VadSiniak/SDS_EV_Charger/README.md

# SDS_EV_Charger
Project helps to make your own low cost EV Charger 

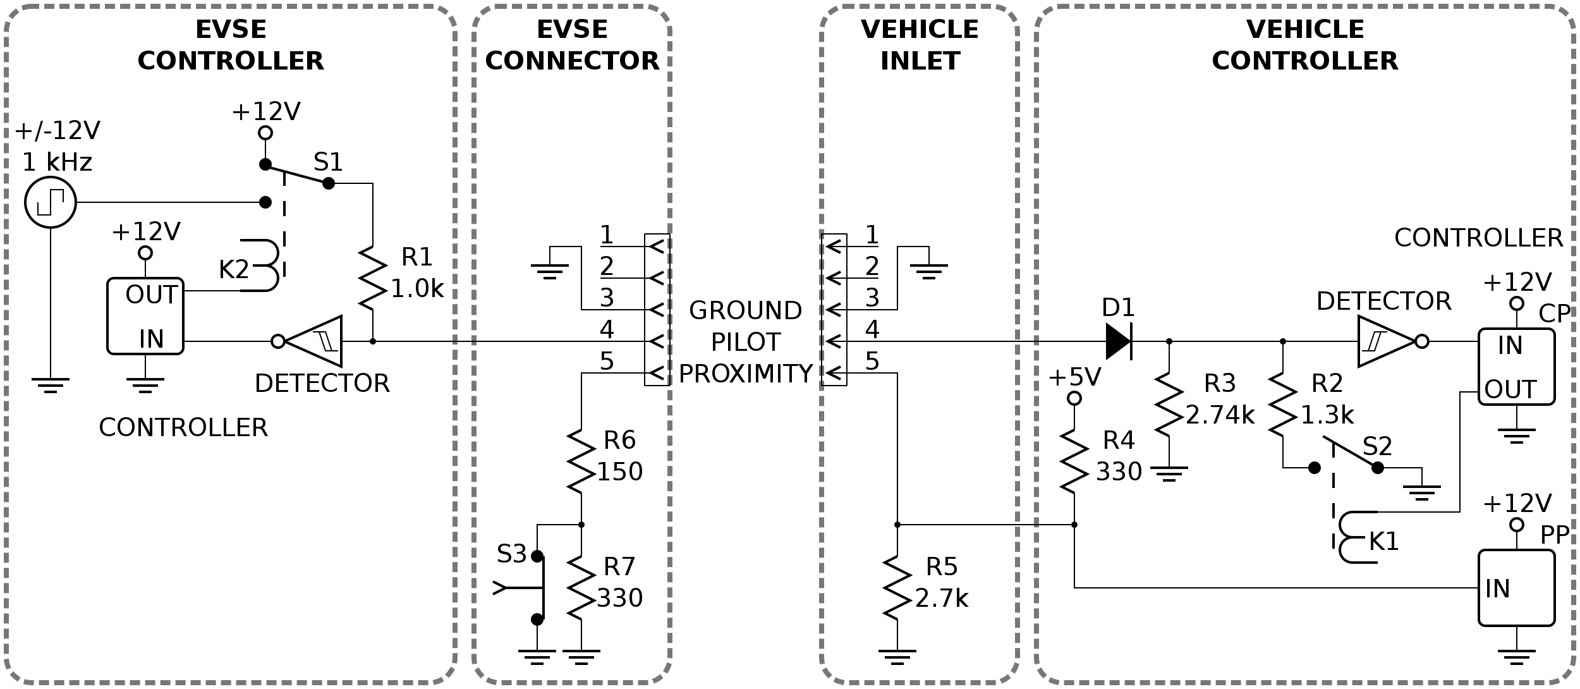
[picture p1: IMG/J1772_signaling_circuit.svg.png]
Schema: EV charger <-> EV


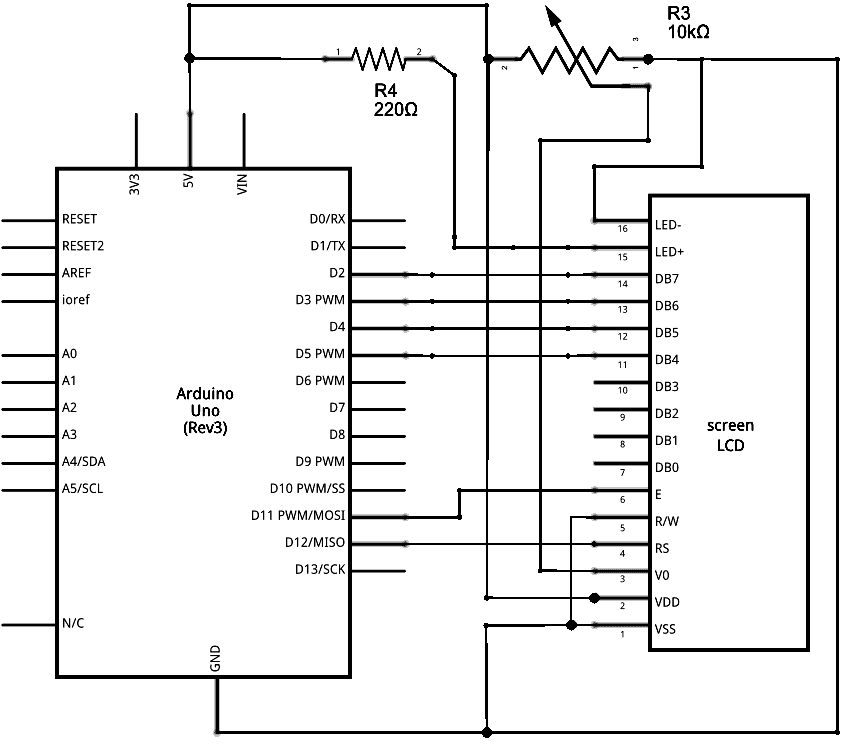
[picture p2: IMG/LCD_Base_bb_Schem.png]
LCD schema
