VadSiniak/SDS_EV_Charger/EV_Charger_home_v1.3/KiCad_proj/EV_Charge.kicad_pcb

## KiCad design EV_Charger_home_v1.3/KiCad_proj/EV_Charge.kicad_pcb (2025-04-10)

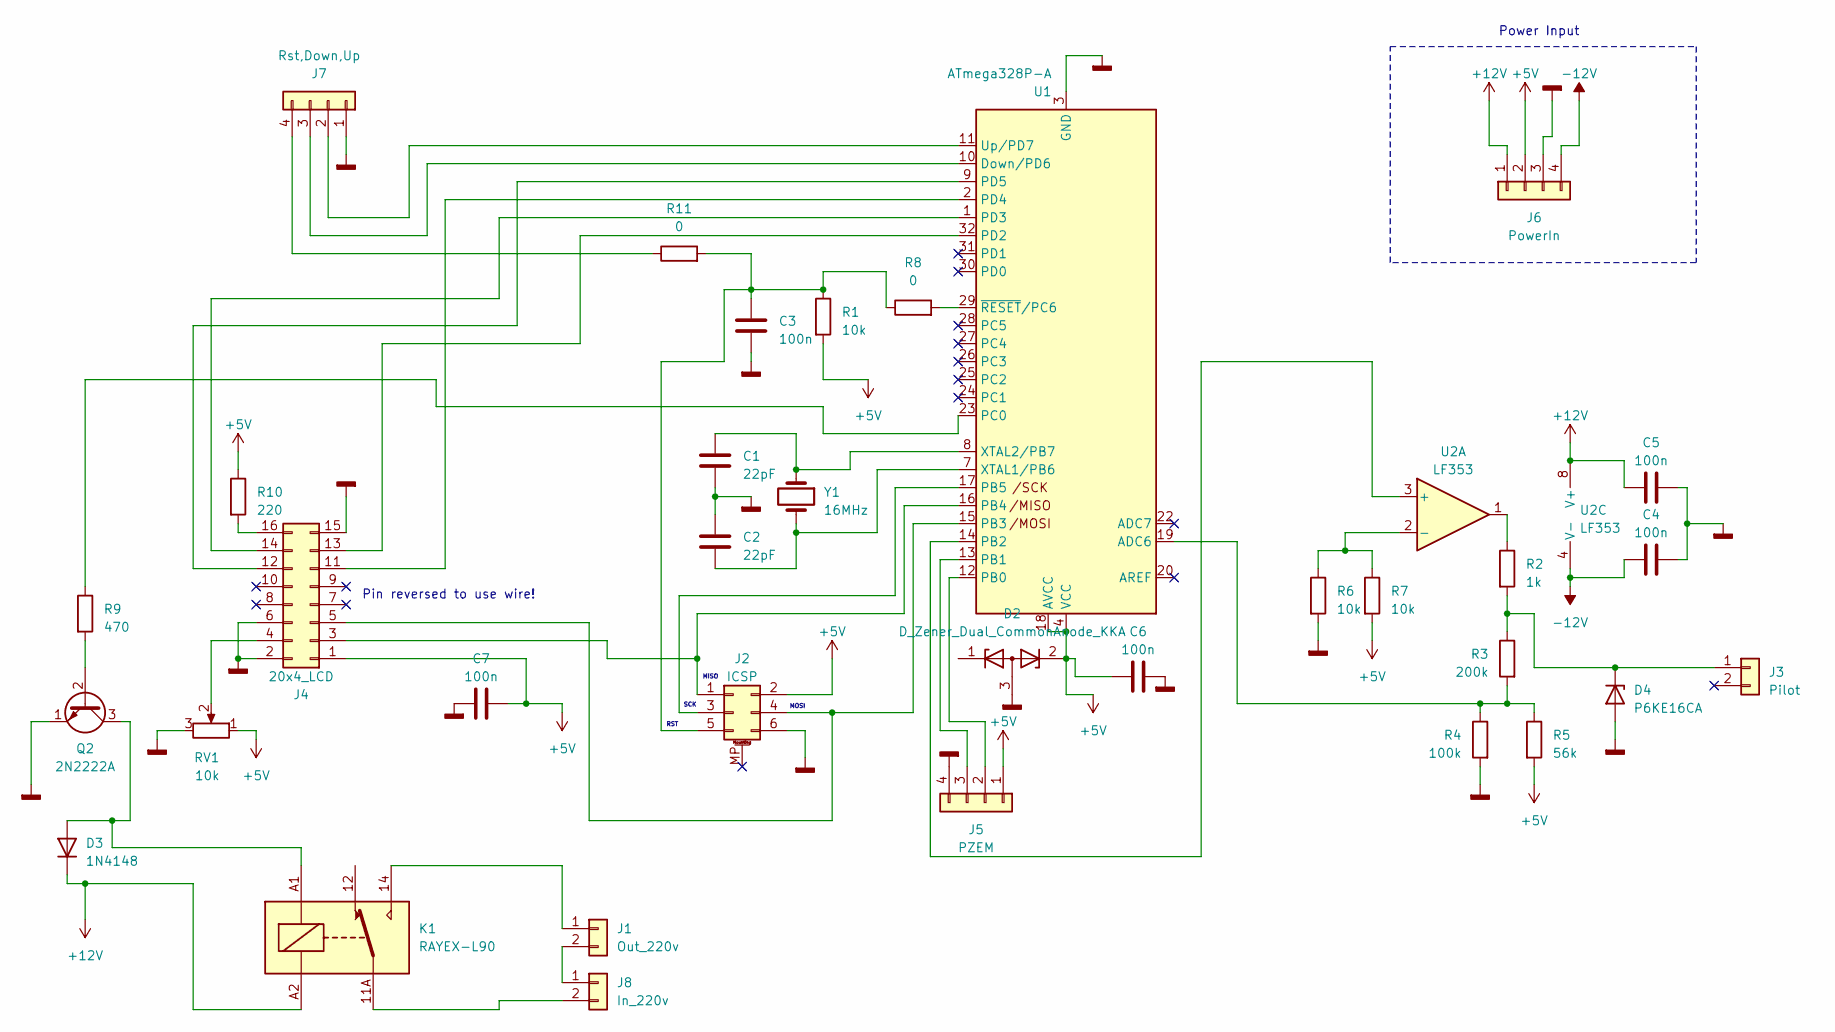
[picture p3: schematic EV_Charge.kicad_sch, J1772 Type1 - Electric Vehicle Charger]

Parts:
C1, C2: 22pF; C_1206_3216Metric_Pad1.33x1.80mm_HandSolder
C3, C4, C5, C6, C7: 100n; C_1206_3216Metric_Pad1.33x1.80mm_HandSolder
D2: D_Zener_Dual_CommonAnode_KKA; TSOT-23
D3: 1N4148; D_DO-15_P5.08mm_Vertical_KathodeUp
D4: P6KE16CA; D_SMB_Handsoldering
J1: Out_220v; Connector_DG950-9.5-Housing
J2: ICSP; PinHeader_2x03_P2.54mm_Vertical
J3: Pilot; PhoenixContact_MCV_1,5_2-G-3.5_1x02_P3.50mm_Vertical
J4: 20x4_LCD; IDC-Header_2x08_P2.54mm_Vertical
J5: PZEM; PhoenixContact_MCV_1,5_4-G-3.5_1x04_P3.50mm_Vertical
J6: PowerIn; PhoenixContact_MCV_1,5_4-G-3.5_1x04_P3.50mm_Vertical
J7: Rst,Down,Up; PhoenixContact_MCV_1,5_4-G-3.5_1x04_P3.50mm_Vertical
J8: In_220v; Connector_DG950-9.5-Housing
K1: RAYEX-L90; Relay_SPDT_RAYEX-L90
Q2: 2N2222A; TO-92L_Wide
R1, R6, R7: 10k; R_2010_5025Metric_Pad1.40x2.65mm_HandSolder
R2: 1k; R_2010_5025Metric_Pad1.40x2.65mm_HandSolder
R3: 200k; R_2010_5025Metric_Pad1.40x2.65mm_HandSolder
R4: 100k; R_2010_5025Metric_Pad1.40x2.65mm_HandSolder
R5: 56k; R_2512_6332Metric_Pad1.40x3.35mm_HandSolder
R8, R11: 0; R_2010_5025Metric_Pad1.40x2.65mm_HandSolder
R9: 470; R_2010_5025Metric_Pad1.40x2.65mm_HandSolder
R10: 220; R_2010_5025Metric_Pad1.40x2.65mm_HandSolder
RV1: 10k; Potentiometer_Runtron_RM-065_Vertical
U1: ATmega328P-A; TQFP-32_7x7mm_P0.8mm
U2: LF353; SO-8_3.9x4.9mm_P1.27mm
Y1: 16MHz; Crystal_SMD_HC49-SD

Connections:
+5V: C6.1, C7.1, D2.2 (K), J2.2, J4.1, J5.1, J6.2, R1.2, R5.2, R7.2, R10.1, RV1.1, U1.4 (VCC), U1.6 (VCC), U1.18 (AVCC)
+12V: C5.1, D3.1 (K), J6.1, K1.A2, U2.8 (V+)
-12V: C4.1, J6.4, U2.4 (V-)
GNDD: C1.2, C2.1, C3.2, C4.2, C5.2, C6.2, C7.2, D2.3 (A), D4.2 (A), J2.6, J4.2, J4.6, J4.15, J5.4, J6.3, J7.1, Q2.1 (E), R4.2, R6.2, RV1.3, U1.3 (GND), U1.5 (GND), U1.21 (GND)
unnamed: D3.2 (A), K1.A1, Q2.3 (C)
unnamed: D4.1 (K), J3.1, R2.2, R3.1
unnamed: J1.1, K1.14
unnamed: J1.2, J8.1
unnamed: J2.1, J4.3, U1.16 (PB4)
unnamed: J2.3, U1.17 (PB5)
unnamed: J2.4, J4.5, U1.15 (PB3)
unnamed: C3.1, J2.5, R1.1, R8.1, R11.2
unnamed: J4.4, RV1.2
unnamed: J4.11, U1.2 (PD4)
unnamed: J4.12, U1.9 (PD5)
unnamed: J4.13, U1.32 (PD2)
unnamed: J4.14, U1.1 (PD3)
unnamed: J4.16, R10.2
unnamed: J5.2, U1.12 (PB0)
unnamed: J5.3, U1.13 (PB1)
unnamed: J7.2, U1.11 (Up/PD7)
unnamed: J7.3, U1.10 (Down/PD6)
unnamed: J7.4, R11.1
unnamed: J8.2, K1.11A, K1.11B
unnamed: Q2.2 (B), R9.2
unnamed: R2.1, U2.1
unnamed: R3.2, R4.1, R5.1, U1.19 (ADC6)
unnamed: U1.14 (PB2), U2.3 (+)
unnamed: R9.1, U1.23 (PC0)
unnamed: C2.2, U1.7 (XTAL1/PB6), Y1.2
unnamed: C1.1, U1.8 (XTAL2/PB7), Y1.1
unnamed: R8.2, U1.29 (~RESET/PC6)
unnamed: R6.1, R7.1, U2.2 (-)

Notes on the sheet:
SCK
Pin reversed to use wire!
Power Input
MOSI
MISO
RST

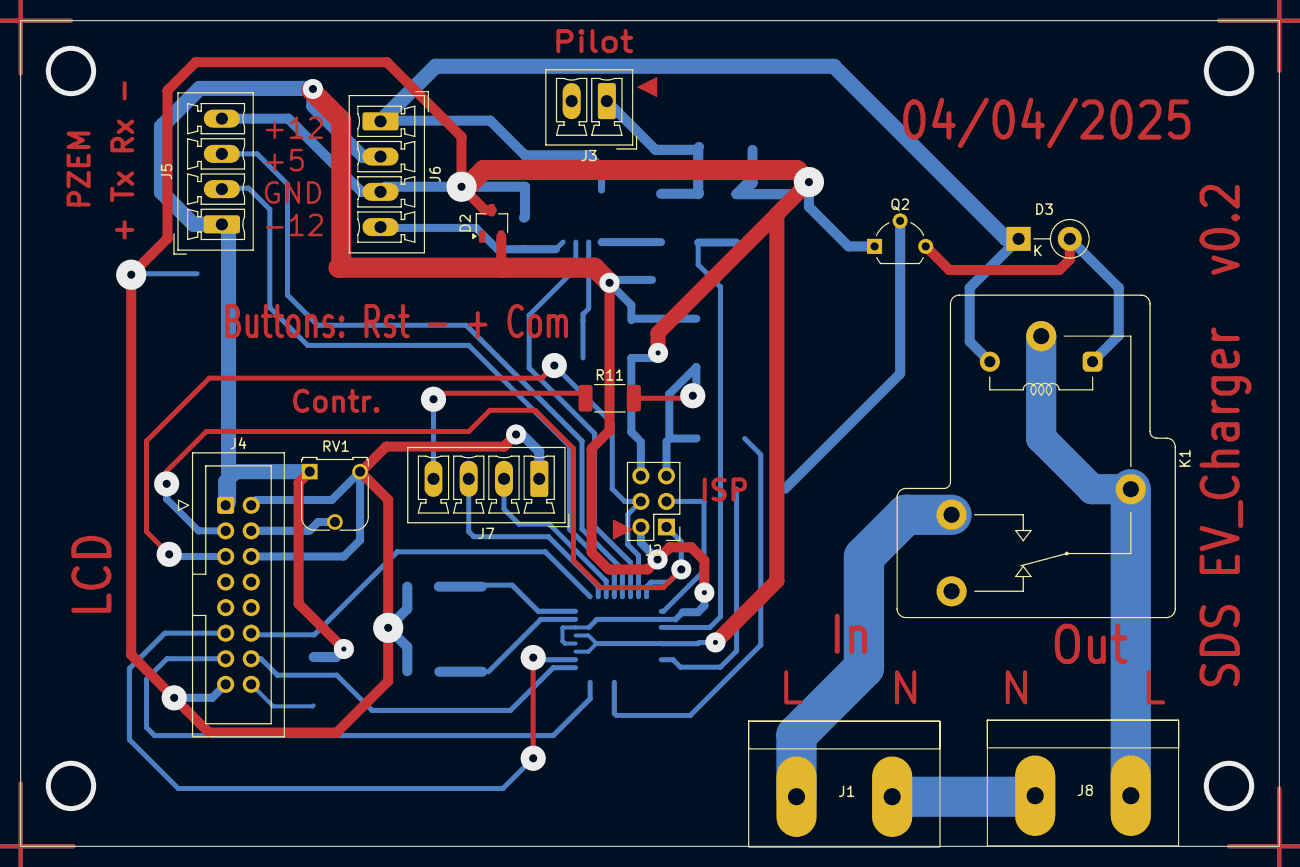
[picture p4: board EV_Charge.kicad_pcb from above]

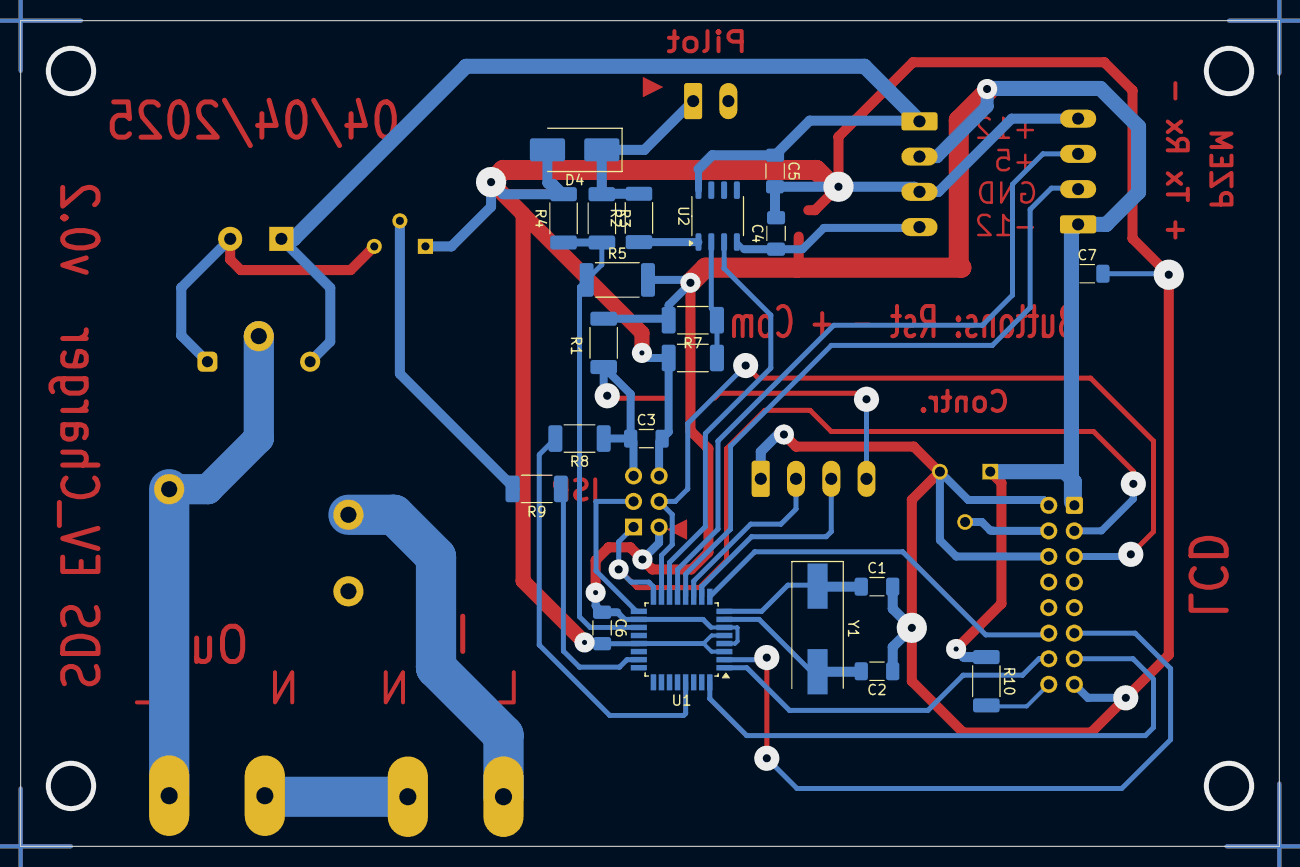
[picture p5: board EV_Charge.kicad_pcb from below]

Board: 2 copper layers, 125.0 x 82.0 mm, 35 parts (21 on the bottom side), 33 nets.
