VadSiniak/SDS_EV_Charger/(commit log)

2025-04-10 Create EV_Charger_home_v1.3.ino
    Added Arduino project file
2025-04-10 Added J1772 and LCD signaling circuit images
2025-04-10 Added KiCad8 project
    [EV_Charge.csv, EV_Charge.kicad_pcb, EV_Charge.kicad_sch, EV_Charge_long.kicad_pcb, EV_Charge_long.kicad_sch]
2025-06-30 Improved button function
